schwedenhof/hiveScale/DOCUMENTATION/manuals/sim800/SIM800L_details.png

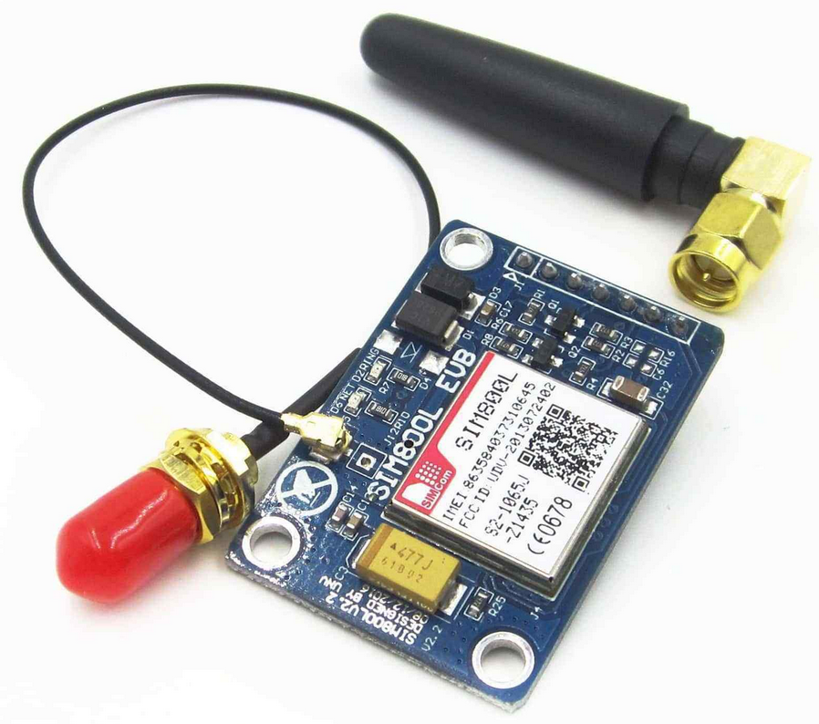
DOCUMENTATION/manuals/sim800/SIM800L_details.png
