schwedenhof/hiveScale/DOCUMENTATION/schematics/hiveScale.png

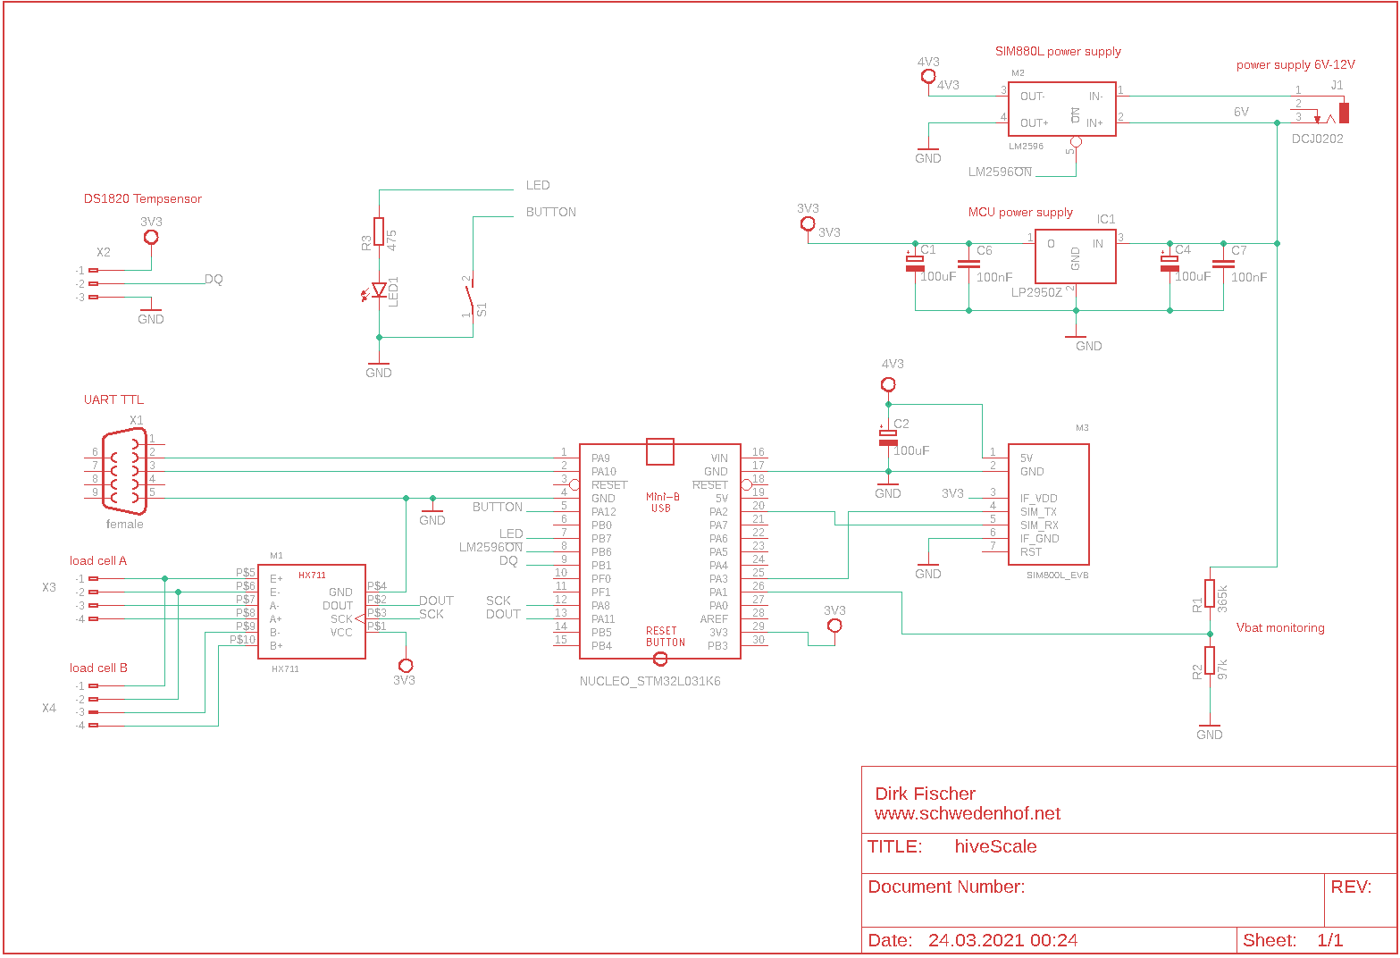
DOCUMENTATION/schematics/hiveScale.png
