schwedenhof/hiveScale/DOCUMENTATION/schematics/hiveScale/hiveScale.sch

## EAGLE design DOCUMENTATION/schematics/hiveScale/hiveScale.sch (2021-03-24)

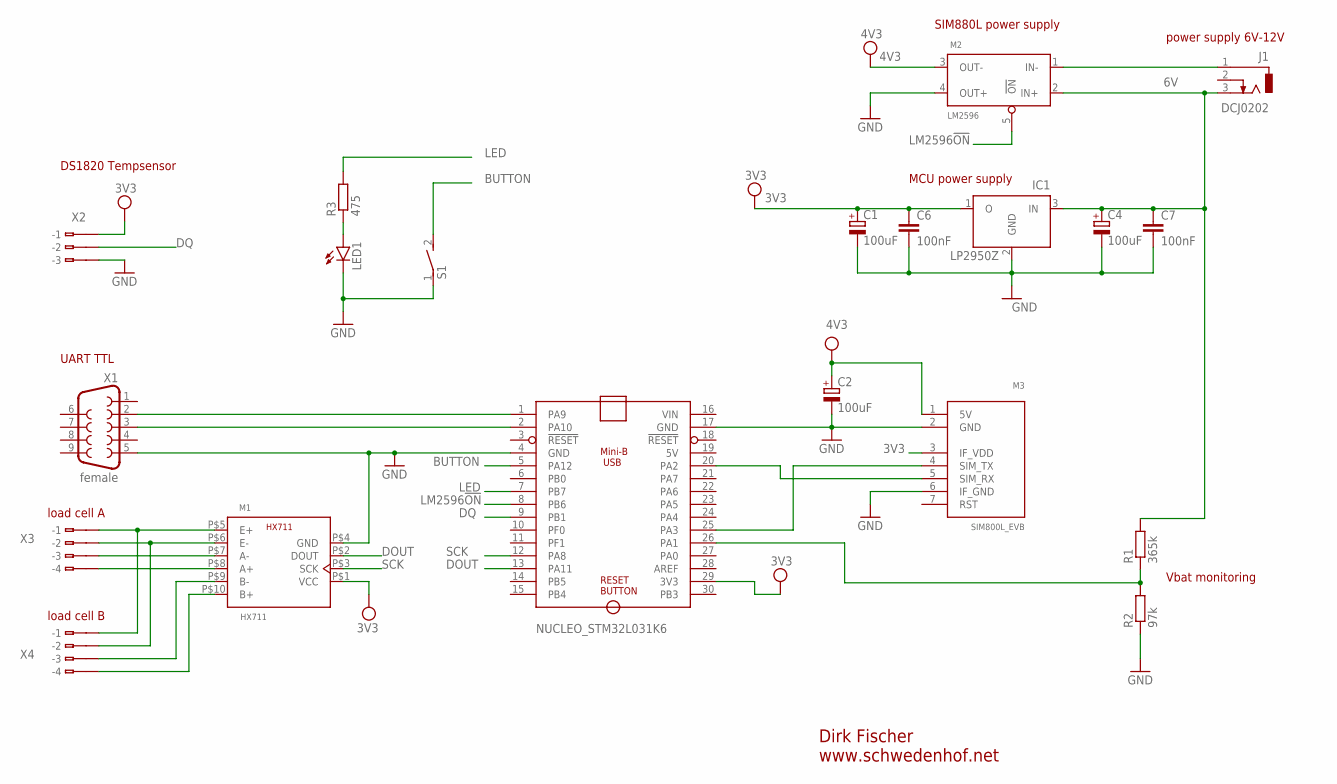
[picture p22: schematic hiveScale.sch]

Parts:
C1, C2, C4: 100uF; 085CS_1AR
C6, C7: 100nF; C025-024X044
IC1: LP2950Z; TO92
J1: DCJ0202
LED1: LED5MM
M1: HX711
M2: LM2596
M3: SIM800L_EVB
NUCLEO_STM32L031K6: ARDUINO_NANO
R1: 365k; 0204/7
R2: 97k; 0204/7
R3: 475; 0204/7
S1: DS01E; DS-01
X1: female; F09VP
X2: 233-103
X3, X4: 233-104

Connections:
3V3: C1.+, C6.1, IC1.1 (O), M1.P$1 (VCC), M3.3 (IF_VDD), NUCLEO_STM32L031K6.29 (3V3), X2.B1 (B-1)
4V3: C2.+, M2.3 (OUT-), M3.1 (5V)
6V: C4.+, C7.1, IC1.3 (IN), J1.3, M2.2 (IN+), R1.2
BUTTON: NUCLEO_STM32L031K6.5 (PA12), S1.2
DOUT: M1.P$2 (DOUT), NUCLEO_STM32L031K6.13 (PA11)
DQ: NUCLEO_STM32L031K6.9 (PB1), X2.B2 (B-2)
GND: C1.-, C2.-, C4.-, C6.2, C7.2, IC1.2 (GND), LED1.K (C), M1.P$4 (GND), M2.4 (OUT+), M3.2 (GND), M3.6 (IF_GND), NUCLEO_STM32L031K6.4 (GND), NUCLEO_STM32L031K6.17 (GND), R2.1, S1.1, X1.5, X2.B3 (B-3)
LED: NUCLEO_STM32L031K6.7 (PB7), R3.2
LM2596!ON: M2.5 (!ON), NUCLEO_STM32L031K6.8 (PB6)
unnamed: M3.5 (SIM_RX), NUCLEO_STM32L031K6.20 (PA2)
unnamed: M3.4 (SIM_TX), NUCLEO_STM32L031K6.25 (PA3)
unnamed: J1.1, M2.1 (IN-)
unnamed: M1.P$5 (E+), X3.B1 (B-1), X4.B1 (B-1)
unnamed: NUCLEO_STM32L031K6.1 (PA9), X1.2
unnamed: NUCLEO_STM32L031K6.26 (PA1), R1.1, R2.2
unnamed: M1.P$6 (E-), X3.B2 (B-2), X4.B2 (B-2)
unnamed: M1.P$7 (A-), X3.B3 (B-3)
unnamed: M1.P$8 (A+), X3.B4 (B-4)
unnamed: M1.P$9 (B-), X4.B3 (B-3)
unnamed: M1.P$10 (B+), X4.B4 (B-4)
unnamed: NUCLEO_STM32L031K6.2 (PA10), X1.3
unnamed: LED1.A, R3.1
SCK: M1.P$3 (SCK), NUCLEO_STM32L031K6.12 (PA8)

Notes on the sheet:
Dirk Fischer www.schwedenhof.net
DS1820 Tempsensor
UART TTL
load cell A
load cell B
power supply 6V-12V
Vbat monitoring
SIM880L power supply
MCU power supply
