schwedenhof/hiveScale/Core/Src/main.c

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
/* Includes ------------------------------------------------------------------*/
#include "main.h"

/* USER CODE BEGIN Includes */
#include "printf.h"
#include <string.h>
#include <stdlib.h>
#include <stdio.h>
#include "remanentDataHandler.h"
#include "terminalHandler.h"
#include "uartHandler.h"
#include "ringBuffer.h"
#include "hx711.h"

/* USER CODE END Includes */

ADC_HandleTypeDef hadc;

UART_HandleTypeDef hlpuart1;
UART_HandleTypeDef huart2;

RTC_HandleTypeDef hrtc;

TIM_HandleTypeDef htim2;
TIM_HandleTypeDef htim21;

/* USER CODE BEGIN PV */
APP_DATA_T g_tAppData={0};


/* USER CODE END PV */

void SystemClock_Config(void);
static void MX_GPIO_Init(void);
static void MX_LPUART1_UART_Init(void);
static void MX_USART2_UART_Init(void);
static void MX_RTC_Init(void);
static void MX_TIM2_Init(void);
static void MX_ADC_Init(void);
static void MX_TIM21_Init(void);
/* USER CODE BEGIN 0 */




void _putchar(char character){

	HAL_UART_Transmit(g_tAppData.tUart[APP_UART2].phUart, (uint8_t*) &character, (uint16_t)1,FASTUART_TIMEOUT);

}




void App_FlashLed(int iLedFlashCnt,uint32_t ulFlashPeriod){
	while(iLedFlashCnt--){
		HAL_GPIO_TogglePin(LED_GPIO_Port, LED_Pin);
		HAL_Delay(ulFlashPeriod);
		HAL_GPIO_TogglePin(LED_GPIO_Port, LED_Pin);
		HAL_Delay(ulFlashPeriod);
	}
}



void HAL_GPIO_EXTI_Callback(uint16_t GPIO_Pin){
	if(GPIO_Pin==UI_INPUT_Pin){
		if(g_tAppData.iSystemStateNext!=APP_SYSTEM_RUN){
			g_tAppData.iSystemStateNext=APP_SYSTEM_WAKEUP;
		}
	}
}

void HAL_RTC_AlarmAEventCallback(RTC_HandleTypeDef* hrtc){
	SystemClock_Config();
	g_tAppData.iSystemStateNext=APP_SYSTEM_ALARM;
}


// TIMEBASE for button and LED handling
void HAL_TIM_PeriodElapsedCallback(TIM_HandleTypeDef *phtim){

	if(phtim==&htim21){
		// LPUART1 RX timeout
		HAL_TIM_Base_Stop_IT(&htim21); // stop timeout timer
		HAL_GPIO_TogglePin(LED_GPIO_Port,  LED_Pin);
		HAL_GPIO_TogglePin(LED_GPIO_Port,  LED_Pin);
		if(g_tAppData.tUart[APP_LPUART1].fRxMsg == UART_RX_ONGOING){
			g_tAppData.tUart[APP_LPUART1].fRxMsg=UART_RX_ENDOFFRAME;
		}
	}


	if(phtim==&htim2){
		// time base for user interface button and LED
		g_tAppData.ulTimTick++;

		if(!(g_tAppData.ulTimTick%g_tAppData.iBlinkPeriod)){
			if(g_tAppData.fBlink){
				HAL_GPIO_WritePin(LED_GPIO_Port, LED_Pin, GPIO_PIN_SET);
			}

			// check user interface input signal
			if(GPIO_PIN_RESET == HAL_GPIO_ReadPin(UI_INPUT_GPIO_Port, UI_INPUT_Pin)){
				// active input signal detected
				switch (g_tAppData.iCmdState){

				case APP_CMD_STATE_IDLE: // start, first active input detected
					g_tAppData.iCmd=1;
					g_tAppData.iCmdState=APP_CMD_STATE_ACTIVE;
					break;

				case APP_CMD_STATE_ACTIVE: // ongoing active input state
					g_tAppData.iCmd++;
					break;

				case APP_CMD_STATE_END: // new active phase, but last cmd not acknowledged yet
					// do nothing
					break;

				default: // should never happen
					g_tAppData.iCmdState=APP_CMD_STATE_IDLE; // reset state machine
					g_tAppData.iCmd=0; // reset cmd code
					break;
				}
			}
		}
		else {
			HAL_GPIO_WritePin(LED_GPIO_Port, LED_Pin, GPIO_PIN_RESET);
		}

		if(GPIO_PIN_SET == HAL_GPIO_ReadPin(UI_INPUT_GPIO_Port, UI_INPUT_Pin)) { // inactive input
			switch (g_tAppData.iCmdState){

			case APP_CMD_STATE_IDLE: // idle wait for first active signal
				g_tAppData.iCmd=APP_CMD_STATE_IDLE; // reset cmd code
				break;

			case APP_CMD_STATE_ACTIVE: // end, first inactive state after active phase
				g_tAppData.iCmdState=APP_CMD_STATE_END;
				break;

			case APP_CMD_STATE_END: // idle, cmd not executed yet, wait for command acknowledge
				break;


			default:  // should never happen
				g_tAppData.iCmdState=APP_CMD_STATE_IDLE; // reset state machine
				g_tAppData.iCmd=0; // reset cmd code
				break;
			}
		}
	}
}






static void App_Init(void){
	g_tAppData.tUart[APP_LPUART1].phUart=&hlpuart1;
	g_tAppData.tUart[APP_UART2].phUart=&huart2;
	g_tAppData.phtim2=&htim2;
	g_tAppData.phtim21=&htim21;
	g_tAppData.phrtc=&hrtc;
	g_tAppData.phadc=&hadc;

	HAL_RTC_GetAlarm(g_tAppData.phrtc, &g_tAppData.tAlarm, RTC_ALARM_A, RTC_FORMAT_BIN);


	g_tAppData.iErrorCnt=0;

	g_tAppData.iSystemState=APP_SYSTEM_STOP;
	g_tAppData.iSystemStateNext=APP_SYSTEM_STOP;

	g_tAppData.fBlink=1;
	g_tAppData.iBlinkPeriod=5;

	g_tAppData.iCmd=0;
	g_tAppData.iCmdState=APP_CMD_STATE_IDLE;


	Rb_BufferClear();

	terminalInitCmdList();
}







void App_Hx711Init(void){
	HX711_CONFIG_T tHx711Config;

	tHx711Config.eGain=HX711_GAIN_128;
	tHx711Config.iIgnoreBits=8;
	tHx711Config.iArraySize=1;
	tHx711Config.iFilterDeviation=40;
	tHx711Config.iMeasurementPause=50;
	tHx711Config.ulTara=g_tAppData.tRemanentData.ulTara;
	tHx711Config.ulCali=g_tAppData.tRemanentData.ulCali;
	hx711_init(&tHx711Config);

}



void App_AlarmInit(void){
	HAL_RTCEx_SetWakeUpTimer_IT(g_tAppData.phrtc, g_tAppData.tRemanentData.ulWakeupPeriod, RTC_WAKEUPCLOCK_CK_SPRE_16BITS);
	g_tAppData.tAlarm.AlarmTime.Hours=g_tAppData.tRemanentData.bAlarmHrs;
	g_tAppData.tAlarm.AlarmTime.Minutes=g_tAppData.tRemanentData.bAlarmMin;
	HAL_RTC_SetAlarm_IT(g_tAppData.phrtc, &g_tAppData.tAlarm, RTC_FORMAT_BIN);
}


APP_RETURN_E App_Sim800On(void){
	return APP_OK;
}


void App_ErrorHandler(void){
	while(1){
	}
}


/* USER CODE END 0 */

/**
  * @brief  The application entry point.
  * @retval int
  */
int main(void)
{
  /* USER CODE BEGIN 1 */
	HAL_StatusTypeDef eStat=HAL_OK;
  /* USER CODE END 1 */

  /* MCU Configuration--------------------------------------------------------*/

  /* Reset of all peripherals, Initializes the Flash interface and the Systick. */
  HAL_Init();

  /* Configure the system clock */
  SystemClock_Config();

  /* Initialize all configured peripherals */
  MX_GPIO_Init();
  MX_LPUART1_UART_Init();
  MX_USART2_UART_Init();
  MX_TIM2_Init();
  MX_ADC_Init();
  MX_TIM21_Init();
  /* USER CODE BEGIN 2 */


	MX_RTC_Init();
#if(0)
	/*##-Check if Data stored in BackUp register1: No Need to reconfigure RTC if flag is set#*/
	/* Read the Back Up Register 0 Data */
	if (!((HAL_RTCEx_BKUPRead(&hrtc, RTC_BKP_DR0)&BKUP_FLAG_RTC))){
		/* Configure RTC Calendar only if flag not set*/
		MX_RTC_Init();
	}
	else {
		hrtc.Instance = RTC;
		hrtc.Init.HourFormat = RTC_HOURFORMAT_24;
		hrtc.Init.AsynchPrediv = 127;
		hrtc.Init.SynchPrediv = 255;
		hrtc.Init.OutPut = RTC_OUTPUT_DISABLE;
		hrtc.Init.OutPutRemap = RTC_OUTPUT_REMAP_NONE;
		hrtc.Init.OutPutPolarity = RTC_OUTPUT_POLARITY_HIGH;
		hrtc.Init.OutPutType = RTC_OUTPUT_TYPE_OPENDRAIN;
		if (HAL_RTC_Init(&hrtc) != HAL_OK)
		{
			Error_Handler();
		}
	}
#endif

	App_Init();
	Term_TerminalCommandHandler(TERM_SIM800_OFF,0,0);

	// start cyclic timer for user interface button and LED -> reload event is handled in callback function
	HAL_TIM_Base_Start_IT(&htim2);
	printf("Hello hiveScale" APP_EOL);

	// start waiting for incoming data -> RX event will be handled in callback function
	HAL_UART_Receive_IT(g_tAppData.tUart[APP_UART2].phUart, &g_tAppData.tUart[APP_UART2].abRxBuffer[g_tAppData.tUart[APP_UART2].iRxIdx], 1);

	Rd_Load((uint8_t*)&g_tAppData.tRemanentData, sizeof(g_tAppData.tRemanentData));
	App_Hx711Init();
	App_AlarmInit();

	// clear wakeup interrupt flag in order to enter standby mode again
	__HAL_PWR_CLEAR_FLAG(PWR_FLAG_WU);
	__HAL_RTC_CLEAR_FLAG(RTC_ISR_ALRAF);

	// start/stop time once
	// not sure why this is necessary, has to be checked
	HAL_TIM_Base_Start_IT(&htim21); // start UART timeout timer
	HAL_TIM_Base_Stop_IT(&htim21); // stop UART timeout timer
	__HAL_TIM_SET_COUNTER(&htim21,0);


#ifdef DEBUG
	g_tAppData.iSystemStateNext=APP_SYSTEM_RUN;
#else
	Term_TerminalCommandHandler(TERM_SIM800_ON,0,0);
	Term_TerminalCommandHandler(TERM_SETTIME,0,0);
	Term_TerminalCommandHandler(TERM_SIM800_OFF,0,0);
#endif



	HAL_RTC_GetTime(g_tAppData.phrtc, &g_tAppData.tTime, RTC_FORMAT_BIN);
	HAL_RTC_GetDate(g_tAppData.phrtc, &g_tAppData.tDate, RTC_FORMAT_BIN);
	printf("%04d-%02d-%02d %02d:%02d:%02d" APP_EOL, g_tAppData.tDate.Year+2000, g_tAppData.tDate.Month, g_tAppData.tDate.Date, g_tAppData.tTime.Hours, g_tAppData.tTime.Minutes, g_tAppData.tTime.Seconds);

  /* USER CODE END 2 */

  /* Infinite loop */
  /* USER CODE BEGIN WHILE */
	while(1){

		g_tAppData.iSystemState=g_tAppData.iSystemStateNext;

		switch(g_tAppData.iSystemState){

		case APP_SYSTEM_STOP:
			Term_TerminalCommandHandler(TERM_BLINK_OFF,0,0);
			Term_TerminalCommandHandler(TERM_SIM800_OFF,0,0);
			Term_TerminalCommandHandler(TERM_STOP,0,0);
			// now sleeping
			// ...
			// wakeup
			if(g_tAppData.iSystemState==g_tAppData.iSystemStateNext)
				g_tAppData.iSystemStateNext=APP_SYSTEM_MEASURE;
			break;

		case APP_SYSTEM_MEASURE:
			Term_TerminalCommandHandler(TERM_HX,0,0);
			if(g_tAppData.iSystemState==g_tAppData.iSystemStateNext)
				g_tAppData.iSystemStateNext=APP_SYSTEM_STOP;
			break;

		case APP_SYSTEM_WAKEUP:
			printf("runmode" APP_EOL);
			Term_TerminalCommandHandler(TERM_BLINK_ON,0,0);
			// start waiting for incoming data -> RX event will be handled in callback function
			Uh_UartReset(APP_UART2);
			g_tAppData.iSystemStateNext=APP_SYSTEM_RUN;
			break;

		case APP_SYSTEM_ALARM:
			HAL_RTC_GetTime(g_tAppData.phrtc, &g_tAppData.tTime, RTC_FORMAT_BIN);
			HAL_RTC_GetDate(g_tAppData.phrtc, &g_tAppData.tDate, RTC_FORMAT_BIN);
			printf("alarm at %04d-%02d-%02d %02d:%02d:%02d" APP_EOL, g_tAppData.tDate.Year+2000, g_tAppData.tDate.Month, g_tAppData.tDate.Date, g_tAppData.tTime.Hours, g_tAppData.tTime.Minutes, g_tAppData.tTime.Seconds);
			Term_TerminalCommandHandler(TERM_SIM800_ON,0,0);
			Term_TerminalCommandHandler(TERM_PUSH,0,0);
			Term_TerminalCommandHandler(TERM_SIM800_OFF,0,0);
			// set next alarm (increment alarm hour by defined value)
			g_tAppData.tAlarm.AlarmTime.Hours+=g_tAppData.tRemanentData.bUploadHoursIncrement;
			if(g_tAppData.tAlarm.AlarmTime.Hours>23)
				g_tAppData.tAlarm.AlarmTime.Hours-=24;

			HAL_RTC_SetAlarm_IT(g_tAppData.phrtc, &g_tAppData.tAlarm, RTC_FORMAT_BIN);



			if(g_tAppData.iSystemState==g_tAppData.iSystemStateNext)
				g_tAppData.iSystemStateNext=APP_SYSTEM_STOP;
			break;

		case APP_SYSTEM_RUN:
		default:
			if(g_tAppData.iCmdState==APP_CMD_STATE_END){
				switch(g_tAppData.iCmd){

				case 2: // 2 pulses
					Term_TerminalCommandHandler(TERM_STARTAPP,0,0);
					break;


				case 5: // 5 pulses
					Term_TerminalCommandHandler(TERM_TARA,0,0);
					break;

				case 6: // 6 pulses
					Term_TerminalCommandHandler(TERM_CALI,0,0);
					break;

				case 7:
					Term_TerminalCommandHandler(TERM_BAT_LOW,0,0);
					break;

				case 8:
					Term_TerminalCommandHandler(TERM_BAT_HIGH,0,0);
					break;


				case 9: // store remanent data
					Term_TerminalCommandHandler(TERM_REMSTORE,0,0);
					break;

				case 10: // test data upload to server
					Term_TerminalCommandHandler(TERM_HX,0,0);
					Term_TerminalCommandHandler(TERM_SIM800_ON,0,0);
					Term_TerminalCommandHandler(TERM_PUSH,0,0);
					Term_TerminalCommandHandler(TERM_SIM800_OFF,0,0);
					break;


				default :
					// unknown cmd code
					break;
				}
				g_tAppData.iCmdState=APP_CMD_STATE_IDLE;
			}



			if(UART_RX_NL==Uh_UartRxWait(APP_UART2, 0)){
				terminalHandler(g_tAppData.tUart[APP_UART2].abDataBuffer, g_tAppData.tUart[APP_UART2].iDataLen);
			}

			if(UART_RX_ONGOING != Uh_UartRxWait(APP_LPUART1, 0)){
				// send (echo) received data to fast usart
				eStat=HAL_UART_Transmit(g_tAppData.tUart[APP_UART2].phUart, g_tAppData.tUart[APP_LPUART1].abDataBuffer, g_tAppData.tUart[APP_LPUART1].iDataLen,FASTUART_TIMEOUT);
				if(eStat==HAL_BUSY){
					g_tAppData.iErrorCnt++;
				}
			}

			// keep SystemStateNext untouched, SystemStateNext might have changed in terminal handler
			break;

		}

#if(0)

		HAL_Delay(500);
		HAL_RTC_WaitForSynchro(&hrtc);
		HAL_RTC_GetTime(&hrtc, &tTime, RTC_FORMAT_BIN);
		tTime.Hours=13;
		tTime.Minutes=10;
		tTime.Seconds=0;
		HAL_RTC_SetTime(&hrtc,&tTime,RTC_FORMAT_BIN);

		HAL_RTC_GetAlarm(&hrtc,&tAlarm,RTC_ALARM_A,RTC_FORMAT_BIN);
		tAlarm.AlarmTime.Hours=13;
		tAlarm.AlarmTime.Minutes=12;
		HAL_RTC_SetAlarm(&hrtc,&tAlarm,RTC_FORMAT_BIN);

#endif


    /* USER CODE END WHILE */

    /* USER CODE BEGIN 3 */
	}
  /* USER CODE END 3 */
}

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
