schwedenhof/hiveScale/Core/Inc/main.h

#define APP_TX_BUFFER_LEN 160
#define UART_RX_BUFFER_LEN 160
#define APP_MAX_TERM_PARAM 5
#define APP_MAX_LOG_DATA_SETS 290  // 12 per hour = 5min interval -> >=288 entries
#define APP_WAKEUPTIME_MINUTES 5
#define APP_RD_MAX_APN_STRING_LEN 35
#define APP_RD_MAX_URL_STRING_LEN 120
#define APP_RD_MAX_KEY_STRING_LEN 20
#define MODULE_SLEEPTIME 300
#define ALARM_MIN 2
#define ALARM_SEC 10
#define ALARM_HR 0
#define TIM_PRESCALER_100USEC_AT_8MHZ 800
#define TIM_PRESCALER_10USEC_AT_8MHZ 80
#define TIM_PRESCALER_1MSEC_AT_8MHZ 8000
#define TIM_PERIOD_100MSEC 100
#define TIM_PERIOD_200MSEC 200
#define TIM_PERIOD_3MSEC 3
#define ADC_BAT_Pin GPIO_PIN_1
#define ADC_BAT_GPIO_Port GPIOA
#define UART_TX_SIM800_Pin GPIO_PIN_2
#define UART_TX_SIM800_GPIO_Port GPIOA
#define UART_RX_SIM800_Pin GPIO_PIN_3
#define UART_RX_SIM800_GPIO_Port GPIOA
#define DS1820_Pin GPIO_PIN_1
#define DS1820_GPIO_Port GPIOB
#define HX711_SCK_Pin GPIO_PIN_8
#define HX711_SCK_GPIO_Port GPIOA
#define VCP_TX_Pin GPIO_PIN_9
#define VCP_TX_GPIO_Port GPIOA
#define VCP_RX_Pin GPIO_PIN_10
#define VCP_RX_GPIO_Port GPIOA
#define HX711_DOUT_Pin GPIO_PIN_11
#define HX711_DOUT_GPIO_Port GPIOA
#define UI_INPUT_Pin GPIO_PIN_12
#define UI_INPUT_GPIO_Port GPIOA
#define UI_INPUT_EXTI_IRQn EXTI4_15_IRQn
#define TMS_Pin GPIO_PIN_13
#define TMS_GPIO_Port GPIOA
#define TCK_Pin GPIO_PIN_14
#define TCK_GPIO_Port GPIOA
#define SIM800_ON_Pin GPIO_PIN_6
#define SIM800_ON_GPIO_Port GPIOB
#define LED_Pin GPIO_PIN_7
#define LED_GPIO_Port GPIOB
#define APP_EOL "\r\n"
#define APP_NL '\n'
#define APP_CR '\r'
#define FASTUART_TIMEOUT 200
#define SIM800_TIMEOUT 2000
#define BKUP_FLAG_RTC (0x00000001U)
