schwedenhof/hiveScale/REPOSITORY/tm_lib/Includes/tm_stm32_delay.h

/**
 * @author  Tilen Majerle
 * @email   tilen@majerle.eu
 * @website http://stm32f4-discovery.net
 * @link    http://stm32f4-discovery.net/2015/07/hal-library-3-delay-for-stm32fxxx/
 * @version v1.0
 * @ide     Keil uVision
 * @license MIT
 * @brief   Library template 
 *	
\verbatim
   ----------------------------------------------------------------------
    Copyright (c) 2016 Tilen Majerle

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
    THE SOFTWARE IS PROVIDED "AS IS", WITHOUT WARRANTY OF ANY KIND,
    EXPRESS OR IMPLIED, INCLUDING BUT NOT LIMITED TO THE WARRANTIES
    OF MERCHANTABILITY, FITNESS FOR A PARTICULAR PURPOSE
    AND NONINFRINGEMENT. IN NO EVENT SHALL THE AUTHORS OR COPYRIGHT
    HOLDERS BE LIABLE FOR ANY CLAIM, DAMAGES OR OTHER LIABILITY,
    WHETHER IN AN ACTION OF CONTRACT, TORT OR OTHERWISE, ARISING 
    FROM, OUT OF OR IN CONNECTION WITH THE SOFTWARE OR THE USE OR
    OTHER DEALINGS IN THE SOFTWARE.
   ----------------------------------------------------------------------
\endverbatim
 */
#ifndef TM_DELAY_H
#define TM_DELAY_H 100

/* C++ detection */
#ifdef __cplusplus
extern "C" {
#endif

/**
 * @addtogroup TM_STM32Fxxx_HAL_Libraries
 * @{
 */

/**
 * @defgroup TM_DELAY
 * @brief    Delay library for STM32Fxxx devices - http://stm32f4-discovery.net/2015/07/hal-library-3-delay-for-stm32fxxx/
 * @{
 *
 * \par Milliseconds delay
 * 
 * Milliseconds delay range is done using Systick interrupts which are made each 1ms.
 * Interrupt handler @ref Systick_Handler() function can be found in project file stm32fxxx_it.c file which should call HAL_IncTick().
 * This function is build in HAL drivers, but has <code>weak</code> parameter which means it can be replaced. 
 * It is replaced in @ref TM_DELAY library.
 *
 * \par Microseconds delay
 * 
 * Microseconds delay range is done using DWT cycle counter to get maximum possible accuracy in 1us delay range.
 * This delay is not supported on STM32F0xx series, because Cortex-M0 does not have DWT section built-in.
 *
 * \par Software timers
 *
 * As mentioned in Milliseconds delay section, library has active Systick timer, which makes interrupt every 1 ms.
 * This allows you also, to make software timers, which has resolution of 1 ms.
 * I've added some support functions for software timers.
 *
 * The main idea of software timers is that when timer reaches zero (timers are down-counters), callback function is called where
 * user can do its work which should be done periodically, or only once if needed. 
 * Check @ref TM_DELAY_Timer_Functions group with all functions which can be used for timers.
 *
 * \par Changelog
 *
\verbatim
 Version 1.0
  - First release
\endverbatim
 *
 * \par Dependencies
 *
\verbatim
 - STM32Fxxx HAL
 - defines.h
\endverbatim
 */

//#include "stm32fxxx_hal.h"
#include "stm32l0xx.h"
#include "main.h"
//#include "defines.h"
#include "stdlib.h"

/**
 * @defgroup TM_DELAY_Macros
 * @brief    Library defines
 * @{
 */

/**
 * @brief  Number of allowed custom timers
 * @note   Should be changes in defines.h file if necessary
 */
#ifndef DELAY_MAX_CUSTOM_TIMERS
#define DELAY_MAX_CUSTOM_TIMERS   5
#endif

/* Memory allocation function */
#ifndef LIB_ALLOC_FUNC
#define LIB_ALLOC_FUNC    malloc
#endif

/* Memory free function */
#ifndef LIB_FREE_FUNC
#define LIB_FREE_FUNC     free
#endif
 
/**
 * @}
 */
 
/**
 * @defgroup TM_DELAY_Typedefs
 * @brief    Library Typedefs
 * @{
 */
 
/**
 * @brief  Custom timer structure
 */
typedef struct _TM_DELAY_Timer_t {
	union {
		struct {			
			uint8_t AREN:1;  /*!< Auto-reload enabled */
			uint8_t CNTEN:1; /*!< Count enabled */
		} F;
		uint8_t FlagsVal;
	} Flags;
	uint32_t ARR;                                        /*!< Auto reload value */
	uint32_t CNT;                                        /*!< Counter value, counter counts down */
	void (*Callback)(struct _TM_DELAY_Timer_t*, void *); /*!< Callback which will be called when timer reaches zero */
	void* UserParameters;                                /*!< Pointer to user parameters used for callback function */
} TM_DELAY_Timer_t;

/**
 * @}
 */

/**
 * @defgroup TM_DELAY_Variables
 * @brief    Library variables
 * @{
 */

extern __IO uint32_t TM_Time;
extern __IO uint32_t TM_Time2;

/**
 * @}
 */

/**
 * @defgroup TM_DELAY_Functions
 * @brief    Library Functions
 * @{
 */

/**
 * @brief  Initializes delay functions 
 * @param  None
 * @retval DWT counter start status
 *           - 0: DWT counter did not start, delay for microseconds won't work
 *           - > 0: DWT counter works OK, delay is ready to use
 */
uint32_t TM_DELAY_Init(void);

/**
 * @brief  Delays for amount of micro seconds
 * @param  micros: Number of microseconds for delay
 * @retval None
 */
__STATIC_INLINE void Delay(__IO uint32_t micros) {
#if !defined(STM32F0xx)
//ToDo:	uint32_t start = DWT->CYCCNT;
	
	/* Go to number of cycles for system */
	micros *= (HAL_RCC_GetHCLKFreq() / 1000000);
	
	/* Delay till end */
	//ToDo:	while ((DWT->CYCCNT - start) < micros);
#else
	/* Go to clock cycles */
	micros *= (SystemCoreClock / 1000000) / 8;
	
	/* Wait till done */
	while (micros--);
#endif
}

/**
 * @brief  Delays for amount of milli seconds
 * @param  millis: Number of milliseconds for delay
 * @retval None
 */
__STATIC_INLINE void Delayms(uint32_t millis) {
	/* Use HAL library for delay ms purpose */
	HAL_Delay(millis);
}

/**
 * @brief  Gets the TM_Time variable value
 * @param  None
 * @retval Current time in milliseconds
 */
#define TM_DELAY_Time()					(TM_Time)

/**
 * @brief  Sets value for TM_Time variable
 * @param  time: Time in milliseconds
 * @retval None
 */
#define TM_DELAY_SetTime(time)			(TM_Time = (time))

/**
 * @brief  Gets the TM_Time2 variable value
 * @param  None
 * @retval Current time in milliseconds
 * @note   This is not meant for public use
 */
#define TM_DELAY_Time2()				(TM_Time2)

/**
 * @brief  Sets value for TM_Time variable
 * @param  time: Time in milliseconds
 * @retval None
 * @note   This is not meant for public use
 */
#define TM_DELAY_SetTime2(time)			(TM_Time2 = (time))

/**
 * @defgroup TM_DELAY_Timer_Functions
 * @brief    Software timer functions
 * @{
 */

/**
 * @brief  Creates a new custom timer which has 1ms resolution
 * @note   It uses @ref malloc for memory allocation for timer structure
 * @param  ReloadValue: Number of milliseconds when timer reaches zero and callback function is called
 * @param  AutoReloadCmd: If set to 1, timer will start again when it reaches zero and callback is called
 * @param  StartTimer: If set to 1, timer will start immediately
 * @param  *TM_DELAY_CustomTimerCallback: Pointer to callback function which will be called when timer reaches zero
 * @param  *UserParameters: Pointer to void pointer to user parameters used as first parameter in callback function
 * @retval Pointer to allocated timer structure
 */
TM_DELAY_Timer_t* TM_DELAY_TimerCreate(uint32_t ReloadValue, uint8_t AutoReloadCmd, uint8_t StartTimer, void (*TM_DELAY_CustomTimerCallback)(struct _TM_DELAY_Timer_t*, void *), void* UserParameters);

/**
 * @brief  Deletes already allocated timer
 * @param  *Timer: Pointer to @ref TM_DELAY_Timer_t structure
 * @retval None
 */
void TM_DELAY_TimerDelete(TM_DELAY_Timer_t* Timer);

/**
 * @brief  Stops custom timer from counting
 * @param  *Timer: Pointer to @ref TM_DELAY_Timer_t structure
 * @retval Pointer to @ref TM_DELAY_Timer_t structure
 */
TM_DELAY_Timer_t* TM_DELAY_TimerStop(TM_DELAY_Timer_t* Timer);

/**
 * @brief  Starts custom timer counting
 * @param  *Timer: Pointer to @ref TM_DELAY_Timer_t structure
 * @retval Pointer to @ref TM_DELAY_Timer_t structure
 */
TM_DELAY_Timer_t* TM_DELAY_TimerStart(TM_DELAY_Timer_t* Timer);

/**
 * @brief  Resets custom timer counter value
 * @param  *Timer: Pointer to @ref TM_DELAY_Timer_t structure
 * @retval Pointer to @ref TM_DELAY_Timer_t structure
 */
TM_DELAY_Timer_t* TM_DELAY_TimerReset(TM_DELAY_Timer_t* Timer);

/**
 * @brief  Sets auto reload feature for timer
 * @note   Auto reload features is used for timer which starts again when zero is reached if auto reload active
 * @param  *Timer: Pointer to @ref TM_DELAY_Timer_t structure
 * @param  AutoReload: Set to 1 if you want to enable AutoReload or 0 to disable
 * @retval Pointer to @ref TM_DELAY_Timer_t structure
 */
TM_DELAY_Timer_t* TM_DELAY_TimerAutoReloadCommand(TM_DELAY_Timer_t* Timer, uint8_t AutoReloadCmd);

/**
 * @brief  Sets auto reload value for timer
 * @param  *Timer: Pointer to @ref TM_DELAY_Timer_t structure
 * @param  AutoReloadValue: Value for timer to be set when zero is reached and callback is called
 * @note   AutoReload feature must be enabled for timer in order to get this to work properly
 * @retval Pointer to @ref TM_DELAY_Timer_t structure
 */
TM_DELAY_Timer_t* TM_DELAY_TimerAutoReloadValue(TM_DELAY_Timer_t* Timer, uint32_t AutoReloadValue);

/**
 * @}
 */

/**
 * @brief  User function, called each 1ms when interrupt from timer happen
 * @note   Here user should put things which has to be called periodically
 * @param  None
 * @retval None
 * @note   With __weak parameter to prevent link errors if not defined by user
 */
void TM_DELAY_1msHandler(void);

/**
 * @}
 */
 
/**
 * @}
 */
 
/**
 * @}
 */

/* C++ detection */
#ifdef __cplusplus
}
#endif

#endif
