schwedenhof/hiveScale/(notices)

Notices in the files:
Core/Inc/main.h:
(C) COPYRIGHT STMicroelectronics *****END OF FILE
